jhuerta0/Bioreactors/BioreactorPartsList.docx

Parts Needed List
Part Number | Description | Picture
EW-45505-82 | Adapter, nylon, male luer to ¼-28 thread 25/pack
EW-45502-56 | Female luer tee, Nylon, 25/pack
UX-45502-26 | Cole-Parmer Female luer x female luer elbow, Nylon, 25/pk
EW-45502-04 | Female luer x 1/8” hose barb adapter, Nylon 25/pack
EW-45502-02 | Female luer x 3/32” hose barb adapter, Nylon 25/pack
EW-45505-04 | Male luer with lock ring x 1/8” hose barb adapter, Nylon, 25/pack

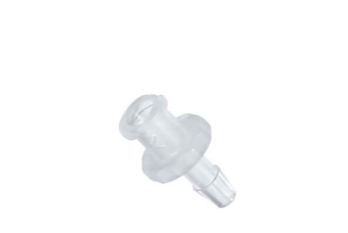
[picture p1: figure]

EW-45502-00 | Female luer x 1/16” hose barb adapter, Nylon, 25/pack
EW-96460-26 | 2-stop Tygon E-lab, Tubing, 0.89 mm, 12/pack
EW-96460-30 | 2-stop Tygon E-lab, Tubing, 1.14 mm, 12/pack

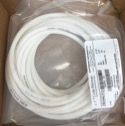
[picture p2: figure]

EW-06424-67 | C-Flex Tubing, 1/8” ID x ¼” OD, 25 ft/pack
00945Q-2 | Omnifit Q-series two-hole bottle cap

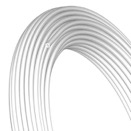
[picture p3: figure]

008T32-150-10 | Tubing, PTFE, 1/8” (3.2 mm) OD x 1.55 mm ID, 10 M
E514116 or B01A29F1R0 | Neoprene Rubber Fender Washers ½” OD x ¼” ID x 1/16” Thickness (100 pack)
Z553905 | Precision Seal Rubber Septa

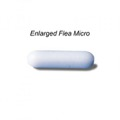
[picture p4: figure]

BA-371191083 | Stir Bar, Magnetic, PTFE, White Flea Micro, 8mm x 3mm
AO-45502-22 | Cole-Parmer Female luer x Female Luer Adapter, Nylon, 25/pk

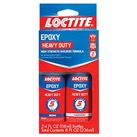
[picture p5: figure]

1365736 or B0044F59N0 | Loctite Heavy Duty Epoxy Quick Set 8-Fluid Ounce Bottle

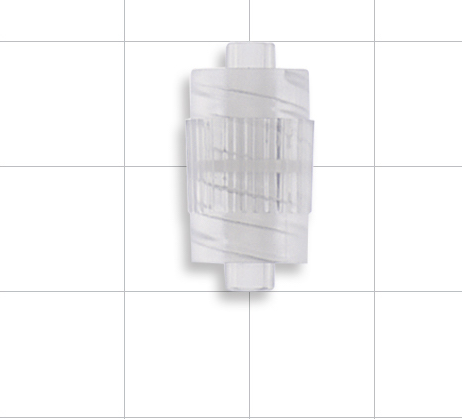
[picture p6: figure]

12090 | Male to Male Luer Lock Connector
