jhuerta0/Bioreactors/Reactor-Holder-b_2018_TanI-Chih.stl

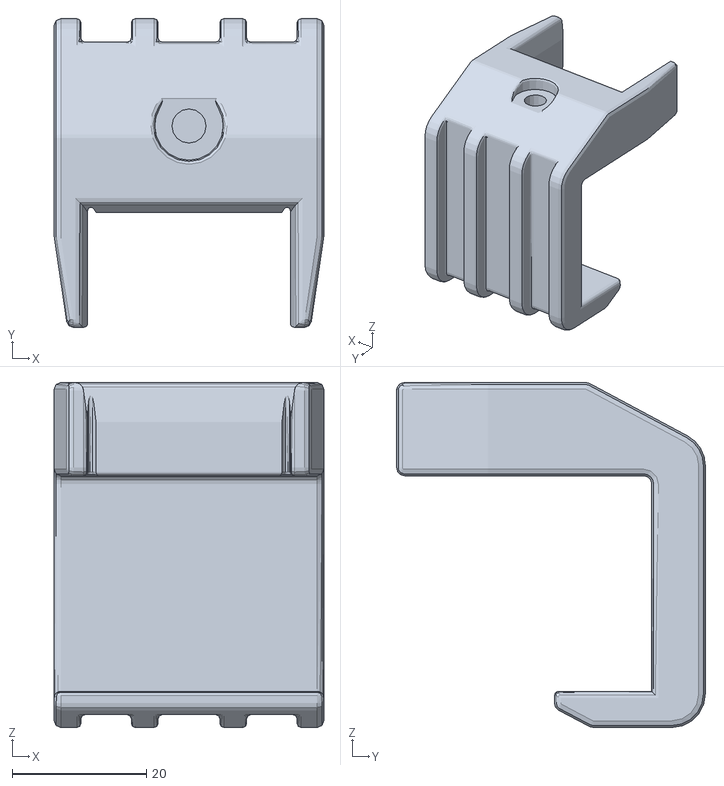
[picture p7: CAD file, 2019-09-21]
Reactor-Holder-b_2018_TanI-Chih.stl
40.2 x 46.0 x 51.4
