jhuerta0/Bioreactors/(list of files, cad)

Other CAD files:
Reactor Strip.dwg
Reactor Holder.dwg
